calstar/iris-power-hw/README.md

View this project on [CADLAB.io](https://cadlab.io/project/23273). 

# iris-power-hw
