calstar/iris-power-hw/IRIS-power/IRIS-power.kicad_pcb

## KiCad design IRIS-power/IRIS-power.kicad_pcb (2020-11-10)

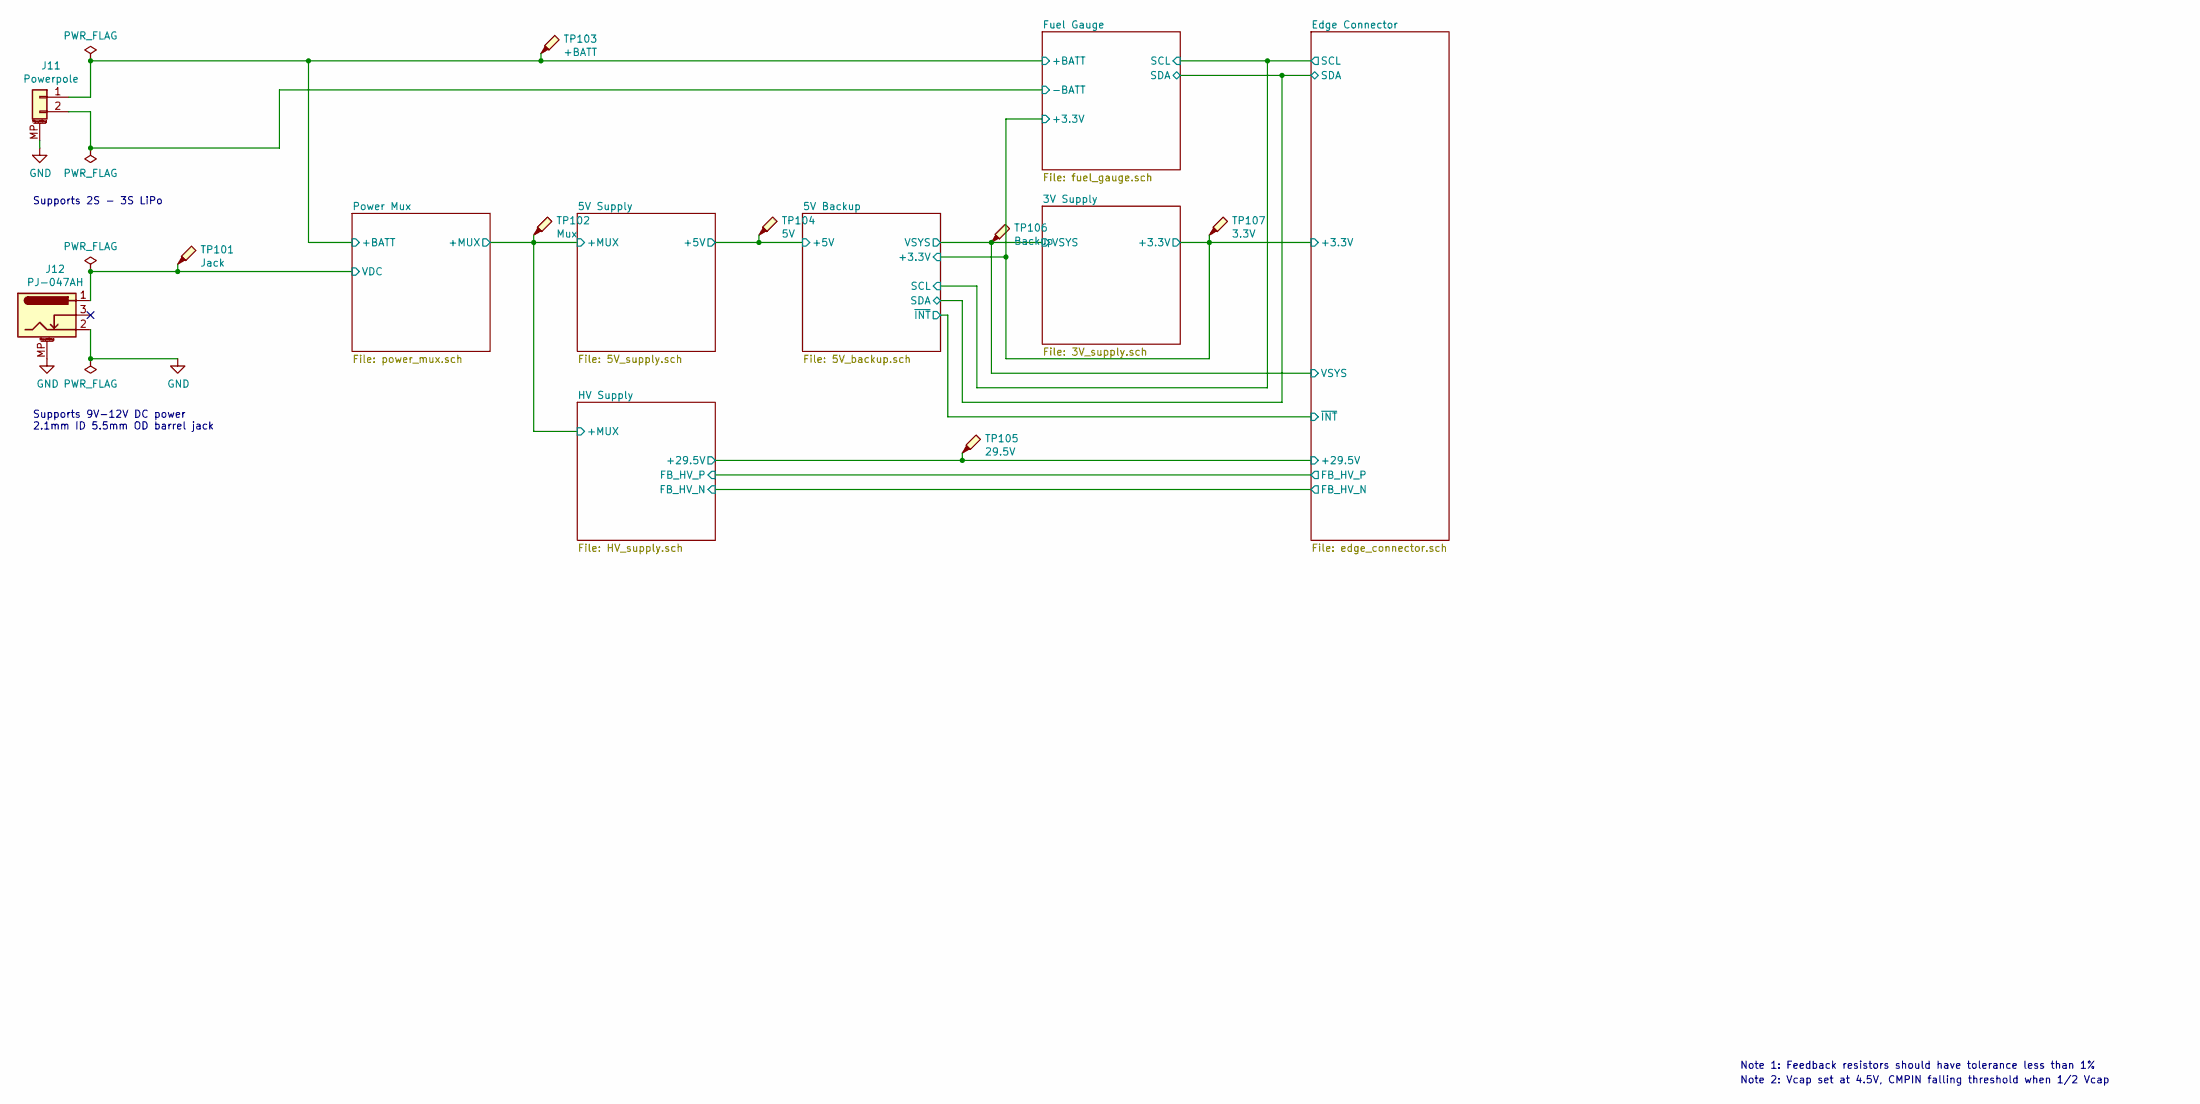
[picture p1: schematic IRIS-power.sch]

Parts:
J11: Powerpole; Powerpole_1336G1; Digikey PN 2243-1336G1-ND
J12: PJ-047AH; CUI_PJ-047AH; Digikey PN CP-047AH-ND
TP101: Jack; TestPoint_Keystone_5000-5004_Miniature; Digikey PN 36-5006-ND
TP102: Mux; TestPoint_Keystone_5000-5004_Miniature; Digikey PN 36-5006-ND
TP103: +BATT; TestPoint_Keystone_5000-5004_Miniature; Digikey PN 36-5006-ND
TP104: 5V; TestPoint_Keystone_5000-5004_Miniature; Digikey PN 36-5006-ND
TP105: 29.5V; TestPoint_Keystone_5000-5004_Miniature; Digikey PN 36-5006-ND
TP106: Backup; TestPoint_Keystone_5000-5004_Miniature; Digikey PN 36-5006-ND
TP107: 3.3V; TestPoint_Keystone_5000-5004_Miniature; Digikey PN 36-5006-ND

Connections:
/3V Supply/+3.3V: TP107.1; also elsewhere on the board
/3V Supply/VSYS: TP106.1; also elsewhere on the board
/5V Backup/+5V: TP104.1; also elsewhere on the board
/5V Supply/+MUX: TP102.1; also elsewhere on the board
/Edge Connector/+29.5V: TP105.1; also elsewhere on the board
/Fuel Gauge/+BATT: J11.1, TP103.1; also elsewhere on the board
/Fuel Gauge/-BATT: J11.2; also elsewhere on the board
/Power Mux/VDC: J12.1, TP101.1; also elsewhere on the board
GND: J11.MP (MountPin), J12.2, J12.MP (MountPin); also elsewhere on the board

Notes on the sheet:
Note 1: Feedback resistors should have tolerance less than 1%
Note 2: Vcap set at 4.5V, CMPIN falling threshold when 1/2 Vcap
Supports 2S - 3S LiPo
Supports 9V-12V DC power 2.1mm ID 5.5mm OD barrel jack

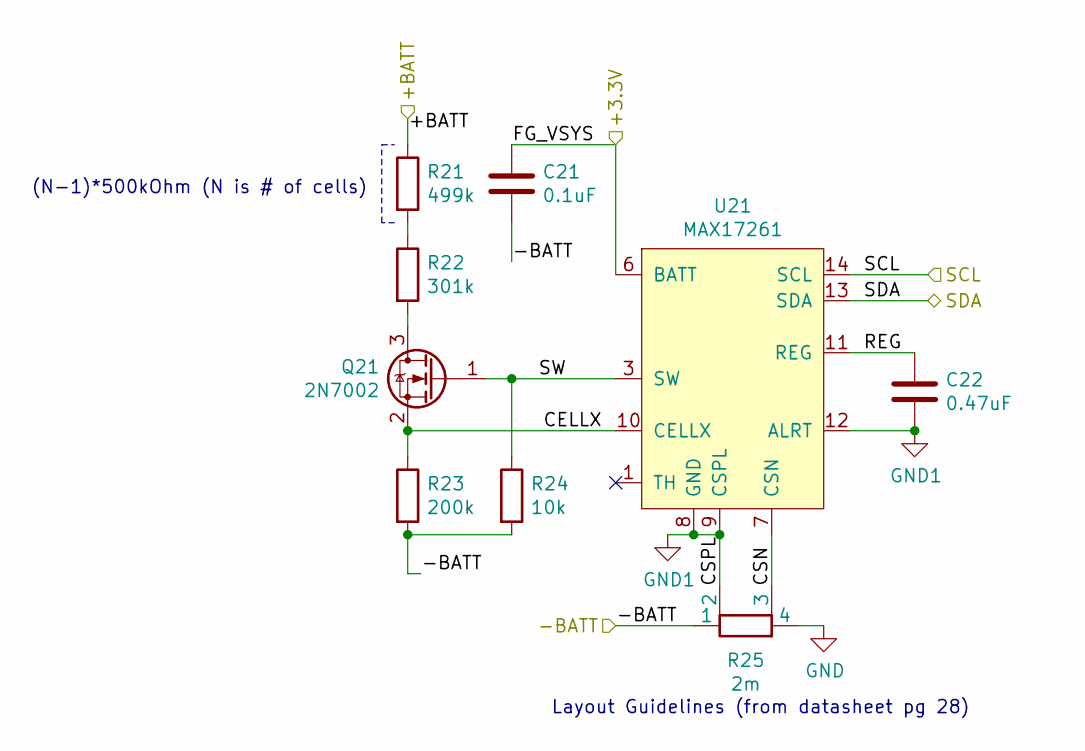
[picture p2: schematic fuel_gauge.sch]

Parts:
C21: 0.1uF; C_0603_1608Metric; Digikey PN 1276-CL10B104KB8NNNLCT-ND
C22: 0.47uF; C_0603_1608Metric; Digikey PN 587-3506-1-ND
Q21: 2N7002; SOT-23; Digikey PN 1727-8643-1-ND
R21: 499k; R_0603_1608Metric; Digikey PN 311-2595-1-ND
R22: 301k; R_0603_1608Metric; Digikey PN RR08P301KDCT-ND
R23: 200k; R_0603_1608Metric; Digikey PN RR08P200KDCT-ND
R24: 10k; R_0603_1608Metric; Digikey PN RNCP0603FTD10K0CT-ND
R25: 2m; CST0612-FC-R002E; MFG PN CST0612-FC-R002E; Digikey PN CST0612-FC-R002ECT-ND
U21: MAX17261; Digikey PN 175-MAX17261METD+TCT-ND

Connections:
/3V Supply/+3.3V: C21.1, U21.6 (BATT); also elsewhere on the board
/5V Backup/SCL: U21.14 (SCL); also elsewhere on the board
/5V Backup/SDA: U21.13 (SDA); also elsewhere on the board
/Fuel Gauge/+BATT: R21.1; also elsewhere on the board
/Fuel Gauge/-BATT: C21.2, R23.2, R24.2, R25.1; also elsewhere on the board
/Fuel Gauge/CELLX: Q21.2 (S), R23.1, U21.10 (CELLX)
/Fuel Gauge/CSN: R25.3, U21.7 (CSN)
/Fuel Gauge/REG: C22.1, U21.11 (REG)
/Fuel Gauge/SW: Q21.1 (G), R24.1, U21.3 (SW)
GND: R25.4; also elsewhere on the board
GND1: C22.2, R25.2, U21.8 (GND), U21.9 (CSPL), U21.12 (ALRT), U21.EP
unnamed: Q21.3 (D), R22.2
unnamed: R21.2, R22.1

Notes on the sheet:
(N-1)*500kOhm (N is # of cells)
Layout Guidelines (from datasheet pg 28)

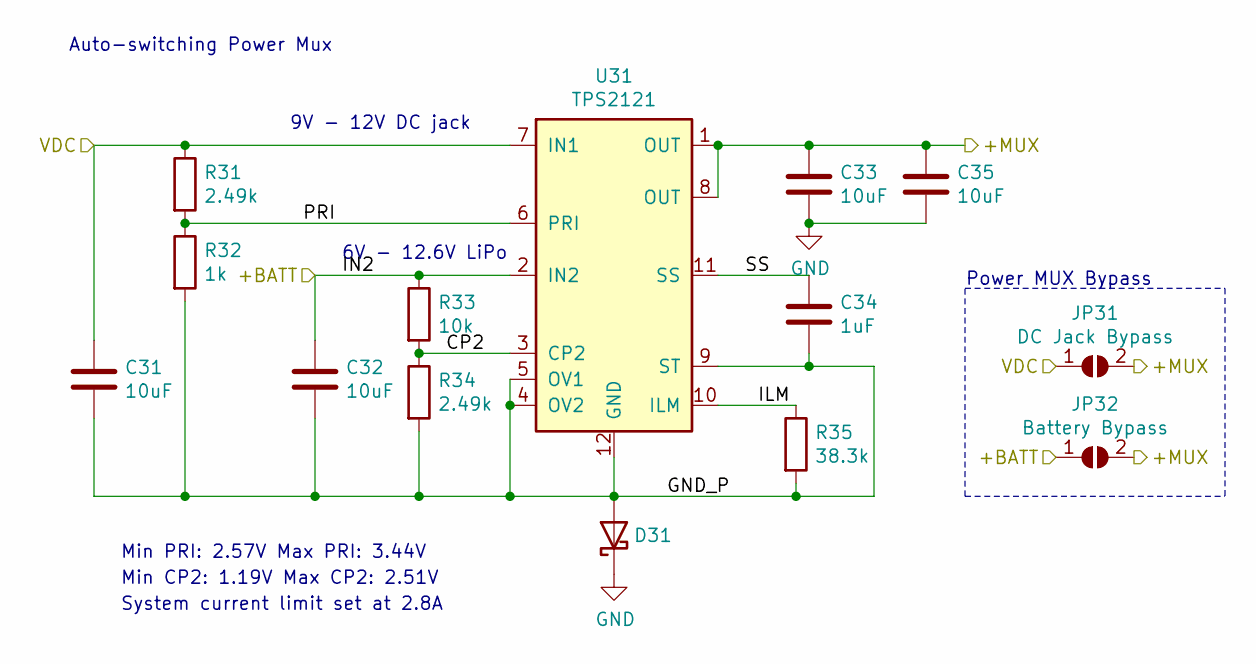
[picture p3: schematic power_mux.sch]

Parts:
C31, C32, C33, C35: 10uF; C_0603_1608Metric; Digikey PN 1276-1192-1-ND
C34: 1uF; C_0603_1608Metric; Digikey PN 1276-1102-1-ND
D31: D_Schottky; D_SMA; MFG PN CDBA240LL-HF; Digikey PN 641-1698-1-ND
JP31: DC Jack Bypass; SolderJumper-2_P1.3mm_Open_RoundedPad1.0x1.5mm
JP32: Battery Bypass; SolderJumper-2_P1.3mm_Open_RoundedPad1.0x1.5mm
R31, R34: 2.49k; R_0603_1608Metric; Digikey PN RNCP0603FTD2K49CT-ND
R32: 1k; R_0603_1608Metric; Digikey PN RMCF0603FT1K00CT-ND
R33: 10k; R_0603_1608Metric; Digikey PN RNCP0603FTD10K0CT-ND
R35: 38.3k; R_0603_1608Metric; Digikey PN RMCF0603FT38K3CT-ND
U31: TPS2121

Connections:
/5V Supply/+MUX: C33.1, C35.1, JP31.2 (B), JP32.2 (B), U31.1 (OUT), U31.8 (OUT); also elsewhere on the board
/Fuel Gauge/+BATT: C32.1, JP32.1 (A), R33.1, U31.2 (IN2); also elsewhere on the board
/Power Mux/CP2: R33.2, R34.1, U31.3 (CP2)
/Power Mux/GND_P: C31.2, C32.2, C34.2, D31.2 (A), R32.2, R34.2, R35.2, U31.4 (OV2), U31.5 (OV1), U31.9 (ST), U31.12 (GND)
/Power Mux/ILM: R35.1, U31.10 (ILM)
/Power Mux/PRI: R31.2, R32.1, U31.6 (PRI)
/Power Mux/SS: C34.1, U31.11 (SS)
/Power Mux/VDC: C31.1, JP31.1 (A), R31.1, U31.7 (IN1); also elsewhere on the board
GND: C33.2, C35.2, D31.1 (K); also elsewhere on the board

Notes on the sheet:
9V - 12V DC jack
6V - 12.6V LiPo
Auto-switching Power Mux
Min PRI: 2.57V Max PRI: 3.44V
Min CP2: 1.19V Max CP2: 2.51V
System current limit set at 2.8A
Power MUX Bypass

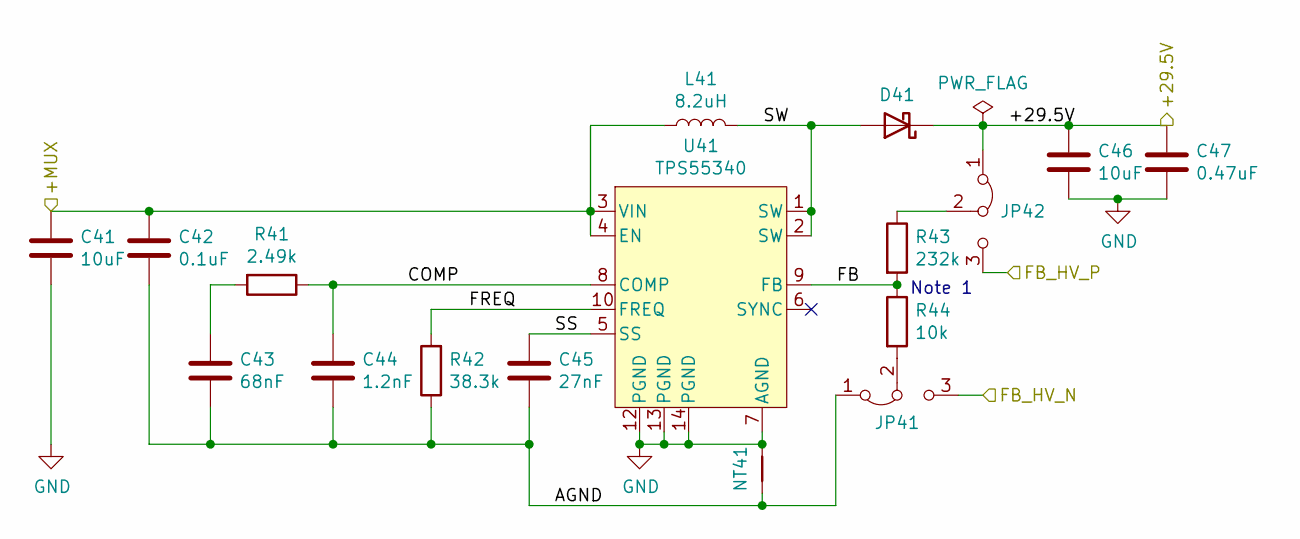
[picture p4: schematic HV_supply.sch]

Parts:
C41: 10uF; C_0603_1608Metric; Digikey PN 1276-1192-1-ND
C42: 0.1uF; C_0603_1608Metric; Digikey PN 1276-CL10B104KB8NNNLCT-ND
C43: 68nF; C_0603_1608Metric; Digikey PN 1276-1814-1-ND
C44: 1.2nF; C_0603_1608Metric; Digikey PN 1276-1951-1-ND
C45: 27nF; C_0603_1608Metric; Digikey PN 1276-2025-1-ND
C46: 10uF; C_0805_2012Metric; Digikey PN 1276-3387-1-ND
C47: 0.47uF; C_0603_1608Metric; Digikey PN 587-3506-1-ND
D41: D_Schottky; D_SMA; MFG PN CDBA240LL-HF; Digikey PN 641-1698-1-ND
JP41, JP42: Jumper_3_Bridged12; PinHeader_1x03_P2.54mm_Vertical
L41: 8.2uH; VLS6045AF; MFG PN VLS6045AF-8R2M; Digikey PN 445-VLS6045AF-8R2MCT-ND
NT41: Net-Tie_2; NetTie-2_SMD_Pad0.5mm
R41: 2.49k; R_0603_1608Metric; Digikey PN RNCP0603FTD2K49CT-ND
R42: 38.3k; R_0603_1608Metric; Digikey PN RMCF0603FT38K3CT-ND
R43: 232k; R_0603_1608Metric; Digikey PN P232KHCT-ND
R44: 10k; R_0603_1608Metric; Digikey PN RNCP0603FTD10K0CT-ND
U41: TPS55340; Digikey PN 296-35493-5-ND

Connections:
/5V Supply/+MUX: C41.1, C42.1, L41.1, U41.3 (VIN), U41.4 (EN); also elsewhere on the board
/Edge Connector/+29.5V: C46.1, C47.1, D41.1 (K), JP42.1 (A); also elsewhere on the board
/Edge Connector/FB_HV_N: JP41.3 (B); also elsewhere on the board
/Edge Connector/FB_HV_P: JP42.3 (B); also elsewhere on the board
/HV Supply/AGND: C42.2, C43.2, C44.2, C45.2, JP41.1 (A), NT41.1, R42.1
/HV Supply/COMP: C44.1, R41.1, U41.8 (COMP)
/HV Supply/FB: R43.2, R44.1, U41.9 (FB)
/HV Supply/FREQ: R42.2, U41.10 (FREQ)
/HV Supply/SS: C45.1, U41.5 (SS)
/HV Supply/SW: D41.2 (A), L41.2, U41.1 (SW), U41.2 (SW)
GND: C41.2, C46.2, C47.2, NT41.2, U41.7 (AGND), U41.11 (NC), U41.12 (PGND), U41.13 (PGND), U41.14 (PGND); also elsewhere on the board
unnamed: C43.1, R41.2
unnamed: JP41.2 (C), R44.2
unnamed: JP42.2 (C), R43.1

Notes on the sheet:
Note 1

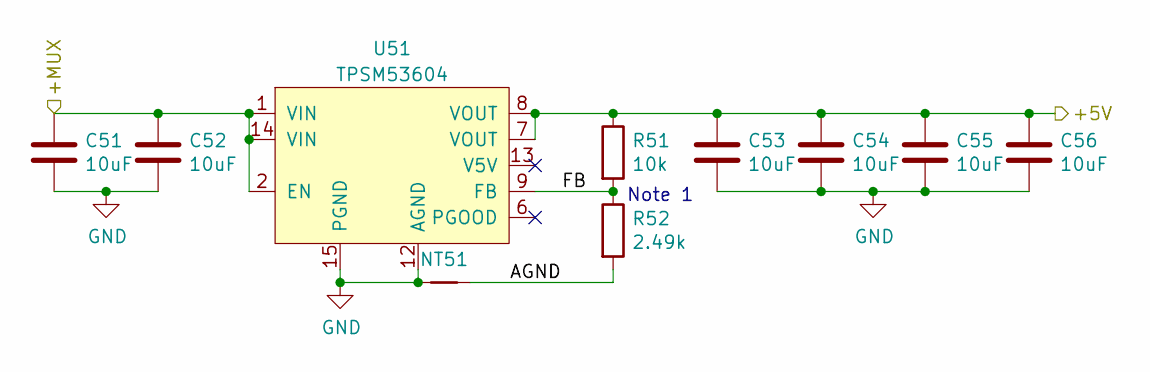
[picture p5: schematic 5V_supply.sch]

Parts:
C51, C52, C53, C54, C55, C56: 10uF; C_0603_1608Metric; Digikey PN 1276-1192-1-ND
NT51: Net-Tie_2; NetTie-2_SMD_Pad0.5mm
R51: 10k; R_0603_1608Metric; Digikey PN RNCP0603FTD10K0CT-ND
R52: 2.49k; R_0603_1608Metric; Digikey PN RNCP0603FTD2K49CT-ND
U51: TPSM53604

Connections:
/5V Backup/+5V: C53.1, C54.1, C55.1, C56.1, R51.1, U51.7 (VOUT), U51.8 (VOUT); also elsewhere on the board
/5V Supply/+MUX: C51.1, C52.1, U51.1 (VIN), U51.2 (EN), U51.14 (VIN); also elsewhere on the board
/5V Supply/AGND: NT51.2, R52.2
/5V Supply/FB: R51.2, R52.1, U51.9 (FB)
GND: C51.2, C52.2, C53.2, C54.2, C55.2, C56.2, NT51.1, U51.3 (NC), U51.10 (NC), U51.11 (NC), U51.12 (AGND), U51.15 (PGND); also elsewhere on the board

Notes on the sheet:
Note 1

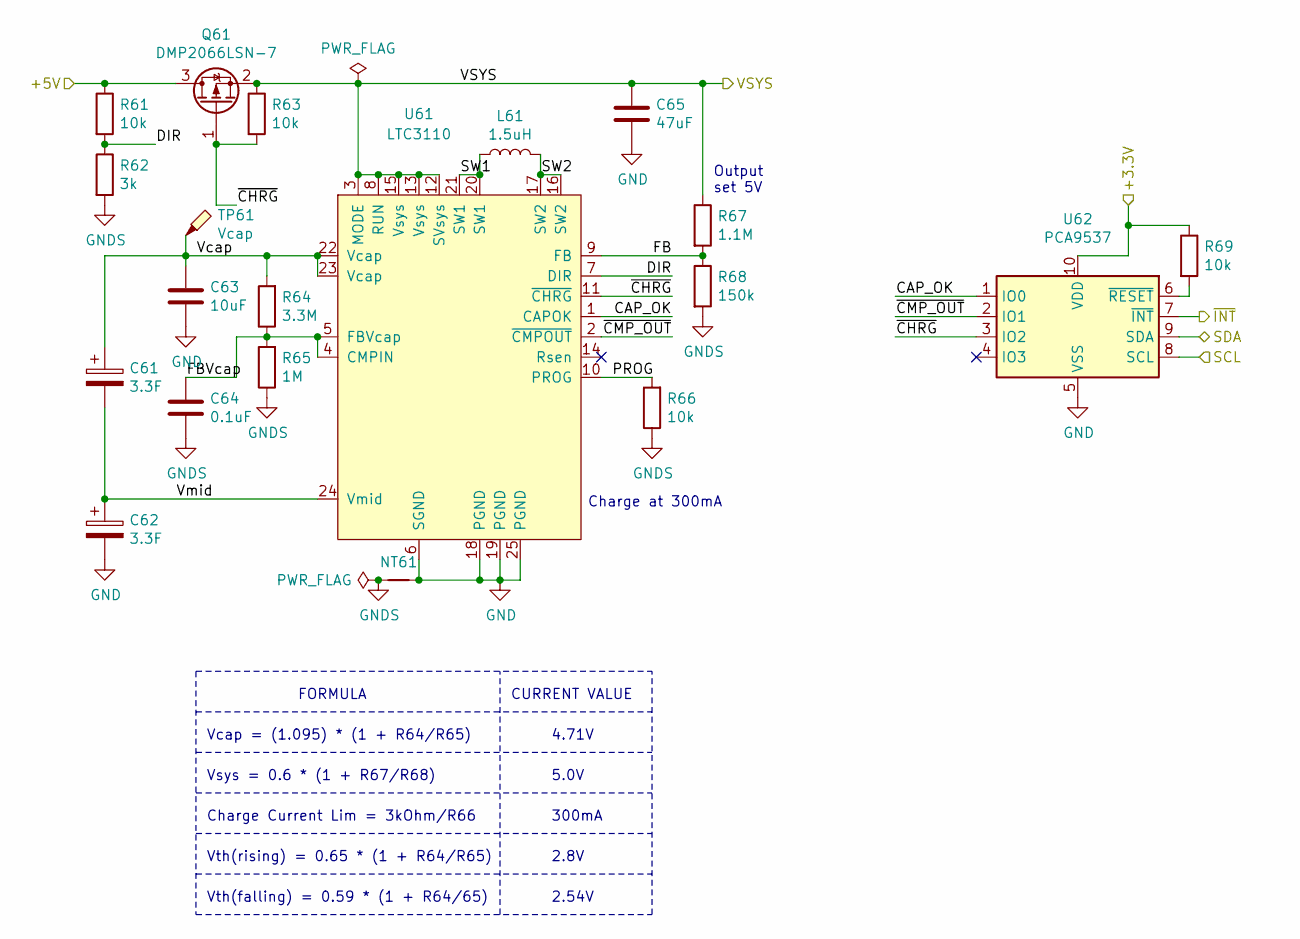
[picture p6: schematic 5V_backup.sch]

Parts:
C61, C62: 3.3F; CAP_10x27_5mm_pitch; Digikey PN 1572-DGH106Q2R7C-ND
C63: 10uF; C_0603_1608Metric; Digikey PN 1276-1192-1-ND
C64: 0.1uF; C_0603_1608Metric; Digikey PN 1276-CL10B104KB8NNNLCT-ND
C65: 47uF; C_1206_3216Metric; Digikey PN 1276-3063-1-ND
L61: 1.5uH; 744316150; MFG PN 744316150; Digikey PN 732-6178-1-ND
NT61: Net-Tie_2; NetTie-2_SMD_Pad0.5mm
Q61: DMP2066LSN-7; SOT-23; Digikey PN DMP2066LSNDICT-ND
R61, R63, R69: 10k; R_0603_1608Metric; Digikey PN RNCP0603FTD10K0CT-ND
R62: 3k; R_0603_1608Metric; Digikey PN RMCF0603FT3K00CT-ND
R64: 3.3M; R_0603_1608Metric; Digikey PN RMCF0603FT3M30CT-ND
R65: 1M; R_0603_1608Metric; Digikey PN RMCF0603FG1M00CT-ND
R66: 10k; R_0603_1608Metric; Digikey PN RMCF0603FT3K00CT-ND
R67: 1.1M; R_0603_1608Metric; Digikey PN 541-1.10MHCT-ND
R68: 150k; R_0603_1608Metric; Digikey PN 311-150KHRCT-ND
TP61: Vcap; TestPoint_Keystone_5000-5004_Miniature; Digikey PN 36-5006-ND
U61: LTC3110
U62: PCA9537; TSSOP-10_3x3mm_P0.5mm; Digikey PN 568-1837-1-ND

Connections:
/3V Supply/+3.3V: R69.1, U62.10 (VDD); also elsewhere on the board
/3V Supply/VSYS: C65.1, Q61.2 (S), R63.1, R67.1, U61.3 (MODE), U61.8 (RUN), U61.12 (SVsys), U61.13 (Vsys), U61.15 (Vsys); also elsewhere on the board
/5V Backup/+5V: Q61.3 (D), R61.1; also elsewhere on the board
/5V Backup/CAP_OK: U61.1 (CAPOK), U62.1 (IO0)
/5V Backup/DIR: R61.2, R62.1, U61.7 (DIR)
/5V Backup/FB: R67.2, R68.1, U61.9 (FB)
/5V Backup/FBVcap: C64.1, R64.1, R65.2, U61.4 (CMPIN), U61.5 (FBVcap)
/5V Backup/PROG: R66.2, U61.10 (PROG)
/5V Backup/SCL: U62.8 (SCL); also elsewhere on the board
/5V Backup/SDA: U62.9 (SDA); also elsewhere on the board
/5V Backup/SW1: L61.1, U61.20 (SW1), U61.21 (SW1)
/5V Backup/SW2: L61.2, U61.16 (SW2), U61.17 (SW2)
/5V Backup/Vcap: C61.1, C63.1, R64.2, TP61.1, U61.22 (Vcap), U61.23 (Vcap)
/5V Backup/Vmid: C61.2, C62.1, U61.24 (Vmid)
/5V Backup/~CHRG: Q61.1 (G), R63.2, U61.11 (~CHRG), U62.3 (IO2)
/5V Backup/~CMP_OUT: U61.2 (~CMPOUT), U62.2 (IO1)
/5V Backup/~INT: U62.7 (~INT); also elsewhere on the board
GND: C62.2, C63.2, C65.2, NT61.2, U61.6 (SGND), U61.18 (PGND), U61.19 (PGND), U61.25 (PGND), U62.5 (VSS); also elsewhere on the board
GNDS: C64.2, NT61.1, R62.2, R65.1, R66.1, R68.2
unnamed: R69.2, U62.6 (~RESET)

Notes on the sheet:
Charge at 300mA
Output set 5V
FORMULA
CURRENT VALUE
4.71V
Vsys = 0.6 * (1 + R67/R68)
Vcap = (1.095) * (1 + R64/R65)
5.0V
Charge Current Lim = 3kOhm/R66
300mA
Vth(rising) = 0.65 * (1 + R64/R65)
Vth(falling) = 0.59 * (1 + R64/65)
2.8V
2.54V

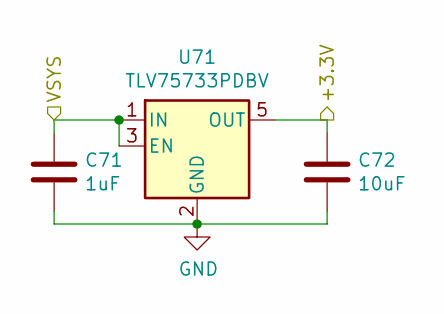
[picture p7: schematic 3V_supply.sch]

Parts:
C71: 1uF; C_0603_1608Metric; Digikey PN 1276-1102-1-ND
C72: 10uF; C_0603_1608Metric; Digikey PN 1276-1192-1-ND
U71: TLV75733PDBV; SOT-23-5; Digikey PN 296-50414-1-ND

Connections:
/3V Supply/+3.3V: C72.1, U71.5 (OUT); also elsewhere on the board
/3V Supply/VSYS: C71.1, U71.1 (IN), U71.3 (EN); also elsewhere on the board
GND: C71.2, C72.2, U71.2 (GND); also elsewhere on the board

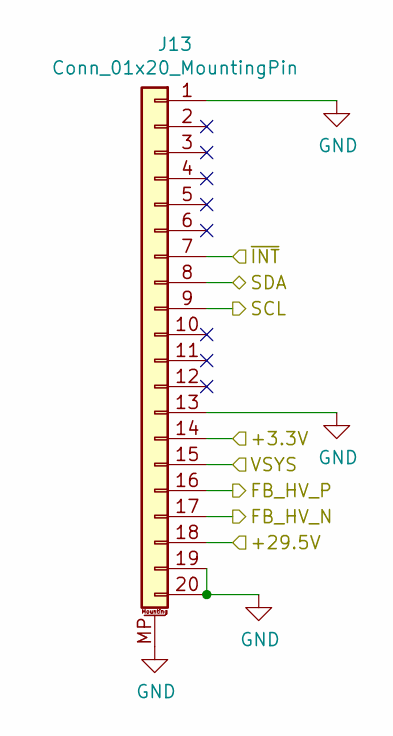
[picture p8: schematic edge_connector.sch]

Parts:
J13: Conn_01x20_MountingPin; IRIS_Muons_physical

Connections:
/3V Supply/+3.3V: J13.14; also elsewhere on the board
/3V Supply/VSYS: J13.15; also elsewhere on the board
/5V Backup/SCL: J13.9; also elsewhere on the board
/5V Backup/SDA: J13.8; also elsewhere on the board
/5V Backup/~INT: J13.7; also elsewhere on the board
/Edge Connector/+29.5V: J13.18; also elsewhere on the board
/Edge Connector/FB_HV_N: J13.17; also elsewhere on the board
/Edge Connector/FB_HV_P: J13.16; also elsewhere on the board
GND: J13.1, J13.13, J13.19, J13.20, J13.MP (MountPin); also elsewhere on the board

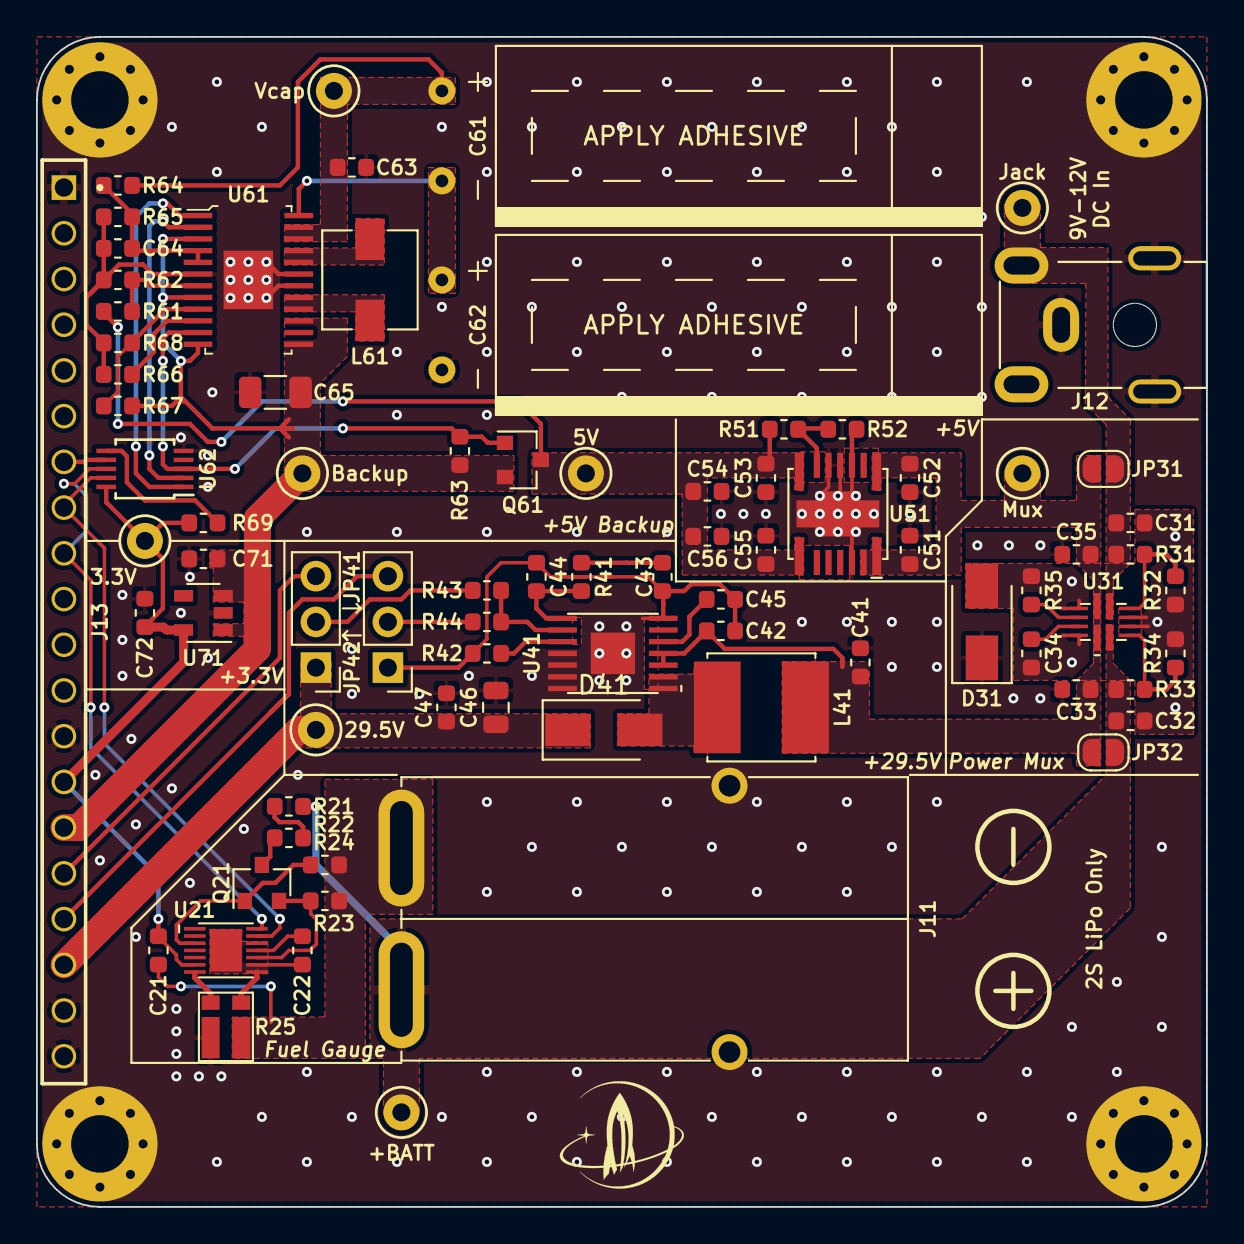
[picture p9: board IRIS-power.kicad_pcb from above]

Board: 2 copper layers, 65.0 x 65.0 mm, 83 parts (0 on the bottom side), 50 nets.
