calstar/iris-power-hw/(commit log)

2020-08-02 Added IRIS power files
    [IRIS-power.kicad_pcb, IRIS-power.sch]
2020-08-03 Added new 5V rail, adjusted passives, added fuel gauge
    [IRIS-power.sch]
2020-08-03 Added more input protection, revised schematic
    [IRIS-power.sch]
2020-08-05 updated library:
    [IRIS-power.sch]
2020-08-07 Updated sheets organization
    [IRIS-power.sch]
2020-08-07 Updated sheet organization
    [3V_supply.sch, 5V_backup.sch, 5V_supply.sch, HV_supply.sch, edge_connector.sch, fuel_gauge.sch, power_inputs.sch, power_mux.sch]
2020-08-09 Finalized power board V2 schematic, preparing to layout
    [3V_supply.sch, 5V_backup.sch, 5V_supply.sch, HV_supply.sch, IRIS-power.sch, edge_connector.sch, fuel_gauge.sch, power_inputs.sch]
2020-08-09 Started layout
    [IRIS-power.kicad_pcb]
2020-08-11 Updated layout
    [5V_backup.sch, 5V_supply.sch, HV_supply.sch, IRIS-power.kicad_pcb, IRIS-power.sch, edge_connector.sch, fuel_gauge.sch, power_mux.sch]
2020-08-19 Finished initial layout without gnd plane
    [3V_supply.sch, 5V_backup.sch, IRIS-power.kicad_pcb]
2020-08-22 Added some 3D models
    [5V_backup.sch, 5V_supply.sch, HV_supply.sch, IRIS-power.kicad_pcb]
2020-08-30 Updated 3D models
    [IRIS-power.kicad_pcb, IRIS-power.sch]
2020-10-23 Begin revising for IRIS V4
    [5V_backup.sch, IRIS-power.kicad_pcb, edge_connector.sch]
2020-10-29 Updated IRIS power board for V4
    [5V_backup.sch, IRIS-power.kicad_pcb, IRIS-power.sch, edge_connector.sch]
2020-11-06 Improved fuel gauge layout
    [3V_supply.sch, 5V_backup.sch, 5V_supply.sch, HV_supply.sch, IRIS-power.kicad_pcb, IRIS-power.sch, fuel_gauge.sch, power_mux.sch]
2020-11-10 Adjusted silkscreen
    [3V_supply.sch, 5V_backup.sch, 5V_supply.sch, HV_supply.sch, IRIS-power.kicad_pcb, IRIS-power.sch, fuel_gauge.sch, power_mux.sch]
